pozsarzs/mm2a/pictures/mm2a-2.jpg

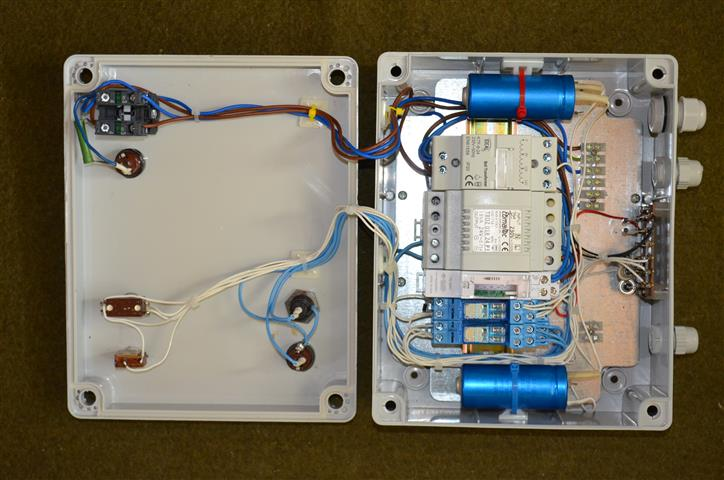
pictures/mm2a-2.jpg
