pozsarzs/mm2a/pictures/mm2a-1.jpg

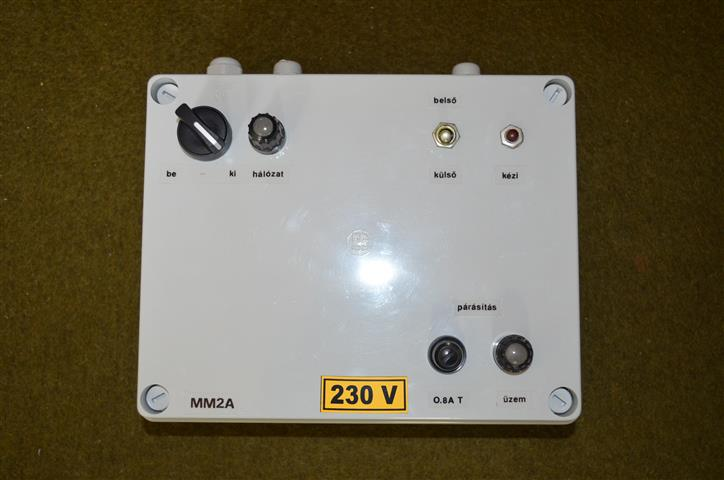
pictures/mm2a-1.jpg
