pozsarzs/mm2a/README.md

**MM2A * Analog one channel growing house controlling device**  
Copyright (C) 2017 Pozsár Zsolt <pozsarzs@gmail.com>  
Homepage: <http://www.pozsarzs.hu>  
GitHub: <https://github.com/pozsarzs/mm2a>

**Documentation**

- version:             1.1
- language:            hu
- licence:             CC-BY-NC-4.0

**Hardware**

 - version:            v170903
