pozsarzs/mm2a/documents/mm2a.pdf

## MM2A egycsatornás analóg gombatermesztő automatika

### Felhasználói leírás

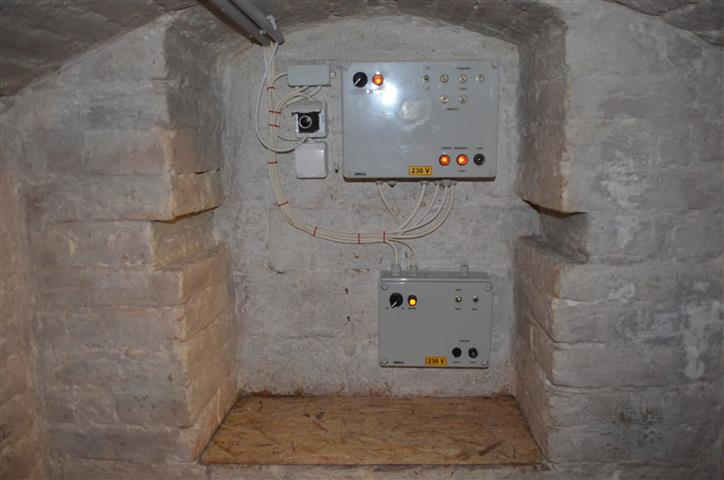
[picture p3: figure]

Hardver változat: v170903
Felhasználói leírás változat: v1.1 Kiadás dátuma: 05/09/2019

## CC-BY-NC-4.0

(59/2)

Tartalomjegyzék

Titles: | MM2A egycsatornás analóg gombatermesztő automatika Rev.: 170903 Pages: | 2/12
Felhasználói leírás
Name: Pozsár Zsolt | Date: | 2019-09-05

## I. A berendezés

Titles: | MM2A egycsatornás analóg gombatermesztő automatika Rev.: 170903 Pages: | 3/12

A készülék a szellőztető rendszertől független, 24V AC mágnesszeleppel működő párásító berendezés vezérlésére képes.

### 1. Műszaki adatok

Tápfeszültség: | 230 V AC
Teljesítményfelvétel: | max. 26 W
Szigetelési osztály: | I. osztály
Mechanikai mérete: | 240 x 190 x 90 mm
IP védettség: | IP 54
IK védettség: | IK 03
Készülékház anyaga: | termoplaszt (ABS)

### 2. Ismertetés

Üzemmódok

| Párásítás
Kézi üzem | van
Belső vezérlés | időzítő
Külső vezérlés | van
Külső vezérlő feszültség | +12 V
Külső vezérlés bemeneti áram | 40 mA
Kimeneti feszültség | 24 V AC
Kimeneti áram | 0,8 A
Kimenet védelem | olvadóbiztosíték
Kimenet visszajelzés | izzó a védelem után

A kimenet az előlapon található olvadóbiztosítékkal (Wickmann) védett. A működést a biztosíték után kapcsolt izzólámpa jelzi. (Bekapcsolt csatorna esetén a lámpa sötét állapota a biztosíték kiégésére utalhat.)

A kimenet a nyomógomb megnyomásával kézzel is aktiválható, a gomb nyomva tartásakor a kimenet kb. 10 mp után automatikusan kikapcsol.

Belső vezérlés esetén a kimenetet a beépített mechanikus időkapcsoló kapcsolja, amely 1 napos időtartamban programozható, a minimális kapcsolási idő 15 perc. A kimenet a beállított időpont elérésekor kb. 10 mp-ig marad aktív.

Külső vezérlés használatakor a bemenetre kapcsolt vezérlőfeszültség kapcsolja a kimenetet. A vonal terhelése induktív (relé), a keletkező ellenkező polaritású impulzus kioltásra kerül. A bemenet fordított

Titles: | MM2A egycsatornás analóg gombatermesztő automatika Rev.: 170903 Pages: | 4/12

polaritású feszültség ellen védett. A működési idő külső vezérlés esetén is kb. 10 mp., a bemeneti jel csak indításra szolgál.

### 3. Kapcsolási rajz

A kapcsolási rajzot az 1. számú melléklet tartalmazza. A rajz a teljes dokumentáció részeként vagy különálló PDF, SVG és KiCAD formátumban letölthető a fejlesztő/gyártó honlapjáról. (A hivatkozásokat a IV. fejezetben találja.)

### 4. Felhasználási feltételek

A hardver dokumentációja a Creativ Commons 4.0 Attribution Non-Commercial (CC-BY-NC-4.0) -„Nevezd meg!-Ne add el!” licenc alapján módosítható és/vagy terjeszthető. A licenc teljes (angol nyelvű) szövegét az interneten tudja elolvasni. (A hivatkozásokat a IV. fejezetben találja.)

### 5. Kinézet


Előlap | A készülék belseje
Titles: | MM2A egycsatornás analóg gombatermesztő automatika Rev.: 170903 Pages: | 5/12

a) Kezelőszervek és csatlakozók

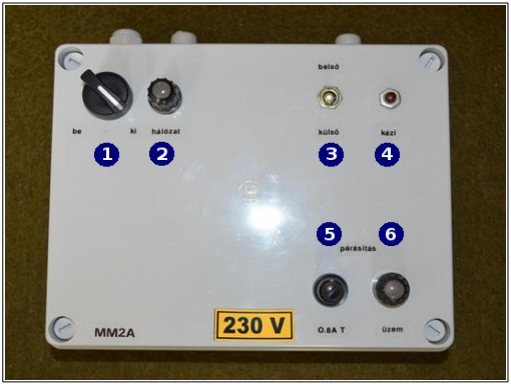
[picture p4: figure]

1: hálózati kapcsoló
2: hálózat visszajelző lámpa
3: külső/belső vezérlés kapcsoló 4: kézi párásítás
5: biztosíték
6: működést jelző lámpa

1: be- és kimeneti csatlakozó 2: külső vezérlés csatlakozó 3: időkapcsoló

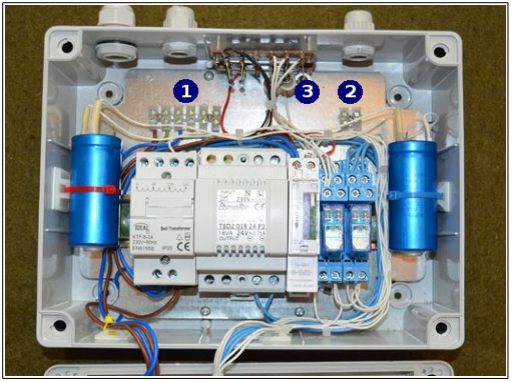
[picture p5: figure]

b) Csatlakozók lábkiosztása

Be- és kimeneti csatlakozó (1): 1: 230 V be L
2: 230 V be PE
3: 230 V be N
4: -
5: párásítás ki
6: párásítás ki

Vezérlés csatlakozó (2):
1: GND
2: párásítás külső vezérlés

(A számozás balról jobbra értendő.)

Titles: | MM2A egycsatornás analóg gombatermesztő automatika Rev.: 170903 Pages: | 6/12

### 6. Letölthető dokumentáció

A hardver teljes dokumentációja .tar.gz formátumú tömörített fájlban letölthető a gyártó honlapjáról. (A hivatkozásokat a IV. fejezetben találja.)

A letölthető csomag neve: mm2a-170903-1.1.tar.gz

A csomag tartalma:

mm2a-170903
│
├───cad_files | | | KiCAD fájlok
│ | mm2a-cache.lib | | | alkatrészkönyvtár
│ | mm2a-rescue.lib | | | alkatrészkönyvtár
│ | mm2a.pro | | | projekt fájl
│ | mm2a.sch | | | kapcsolási rajz
│
├───documents | | | dokumentáció
│ | mm2a.pdf | | | Felhasználói leírás
│ | manual-source.tar.bz2 | | | Felhasználói leírás forrás
│
├───pictures | | | képek
│ | sch_mm2a.svg | | | kapcsolási rajz
│ | mm2a-1.jpg | | | előlap
│ | mm2a-2.jpg | | | belső felépítés
│
├───LICENCE | | felhasználási feltételek
└───README | | rövid ismertető
Titles: | MM2A egycsatornás analóg gombatermesztő automatika Rev.: 170903 Pages: | 7/12

## II. Kapcsolódó hivatkozások

Titles: | MM2A egycsatornás analóg gombatermesztő automatika Rev.: 170903 Pages: | 8/12

### 1. Készülék

Teljes dokumentáció | http://www.szerafingomba.hu/equipments/mm2a/mm2a-170903-1.1.tar.gz
Felhasználói leírás | http://www.szerafingomba.hu/equipments/mm2a/user-manual-170903-1.1.pdf

Kapcsolási rajz:
PDF | http://www.szerafingomba.hu/equipments/mm2a/sch_mm2a.pdf
SVG | http://www.szerafingomba.hu/equipments/mm2a/sch_mm2a.svg
KiCAD | http://www.szerafingomba.hu/equipments/mm2a/sch_mm2a.tar.gz

### 2. Felhasználási feltételek

CC-BY-NC-4.0 (EN) | https://creativecommons.org/licenses/by-nc/4.0/legalcode
CC-BY-NC-4.0 (EN) | https://creativecommons.org/licenses/by-nc/4.0/
CC-BY-NC-4.0 (HU) | https://creativecommons.org/licenses/by-nc/4.0/deed.hu

### 3. Fejlesztő és gyártó

Honlap | https://www.szerafingomba.hu
E-mail | info@szerafingomba.hu
Titles: | MM2A egycsatornás analóg gombatermesztő automatika Rev.: 170903 Pages: | 9/12

## III. Mellékletek

Titles: | MM2A egycsatornás analóg gombatermesztő automatika Rev.: 170903 Pages: | 10/12

### 1. Kapcsolási rajzok

1. MM2A kapcsolási rajza
Titles: | MM2A egycsatornás analóg gombatermesztő automatika Rev.: 170903 Pages: | 11/12

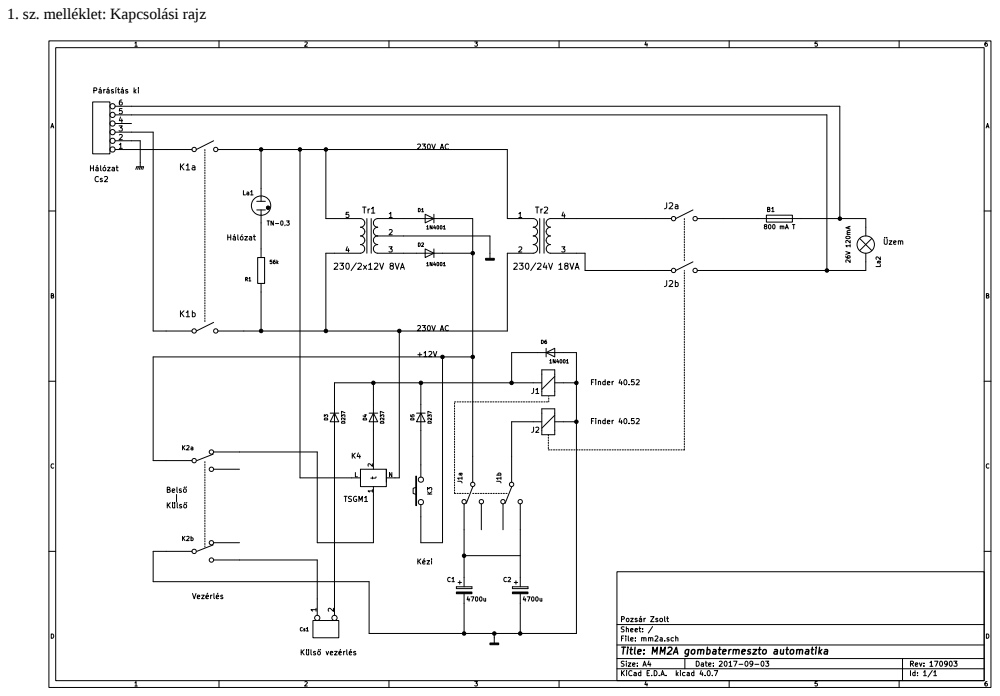
[picture p6: page 12]

1. sz. melléklet: Kapcsolási rajz
