pozsarzs/mm2a/documents/sch_mm2a.pdf

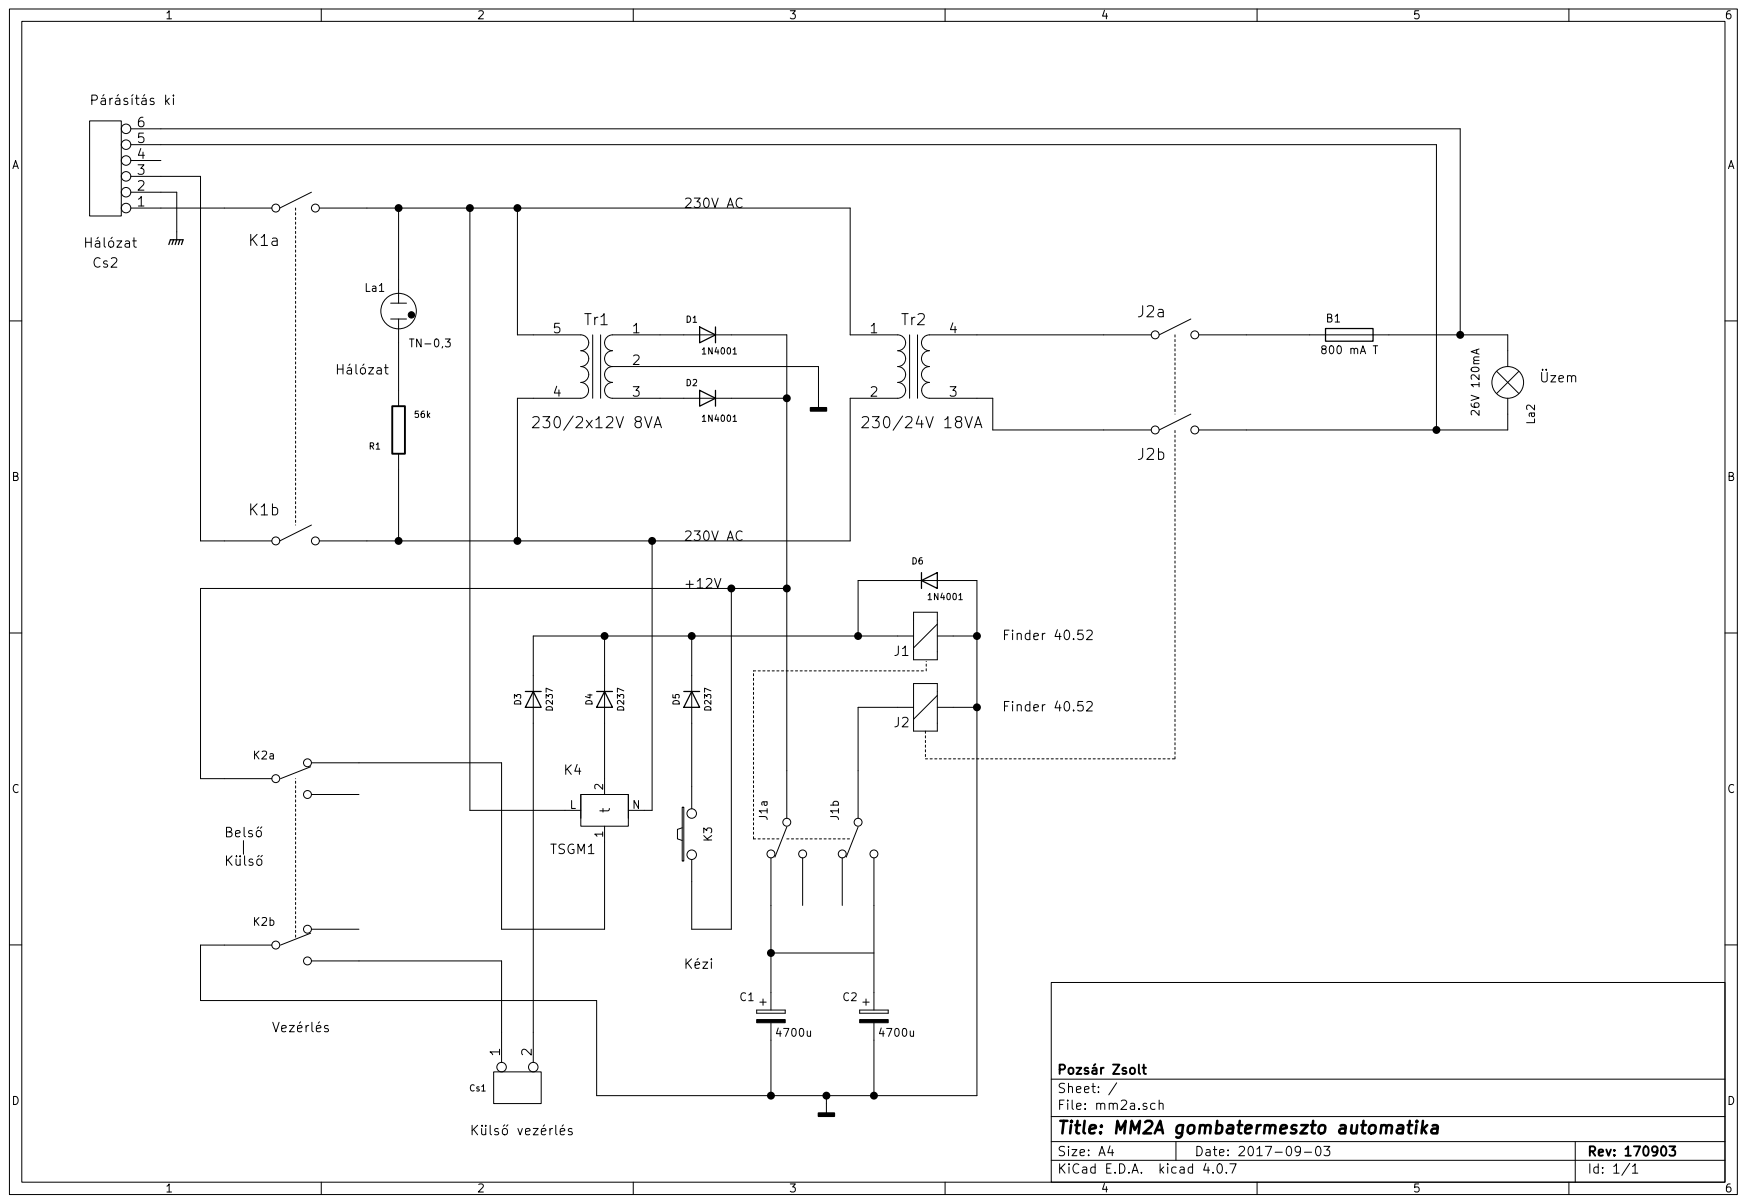
[picture p7: page 1]
