pozsarzs/mm2a/cad_files/mm2a.sch

## KiCad design cad_files/mm2a.sch (2018-12-22)

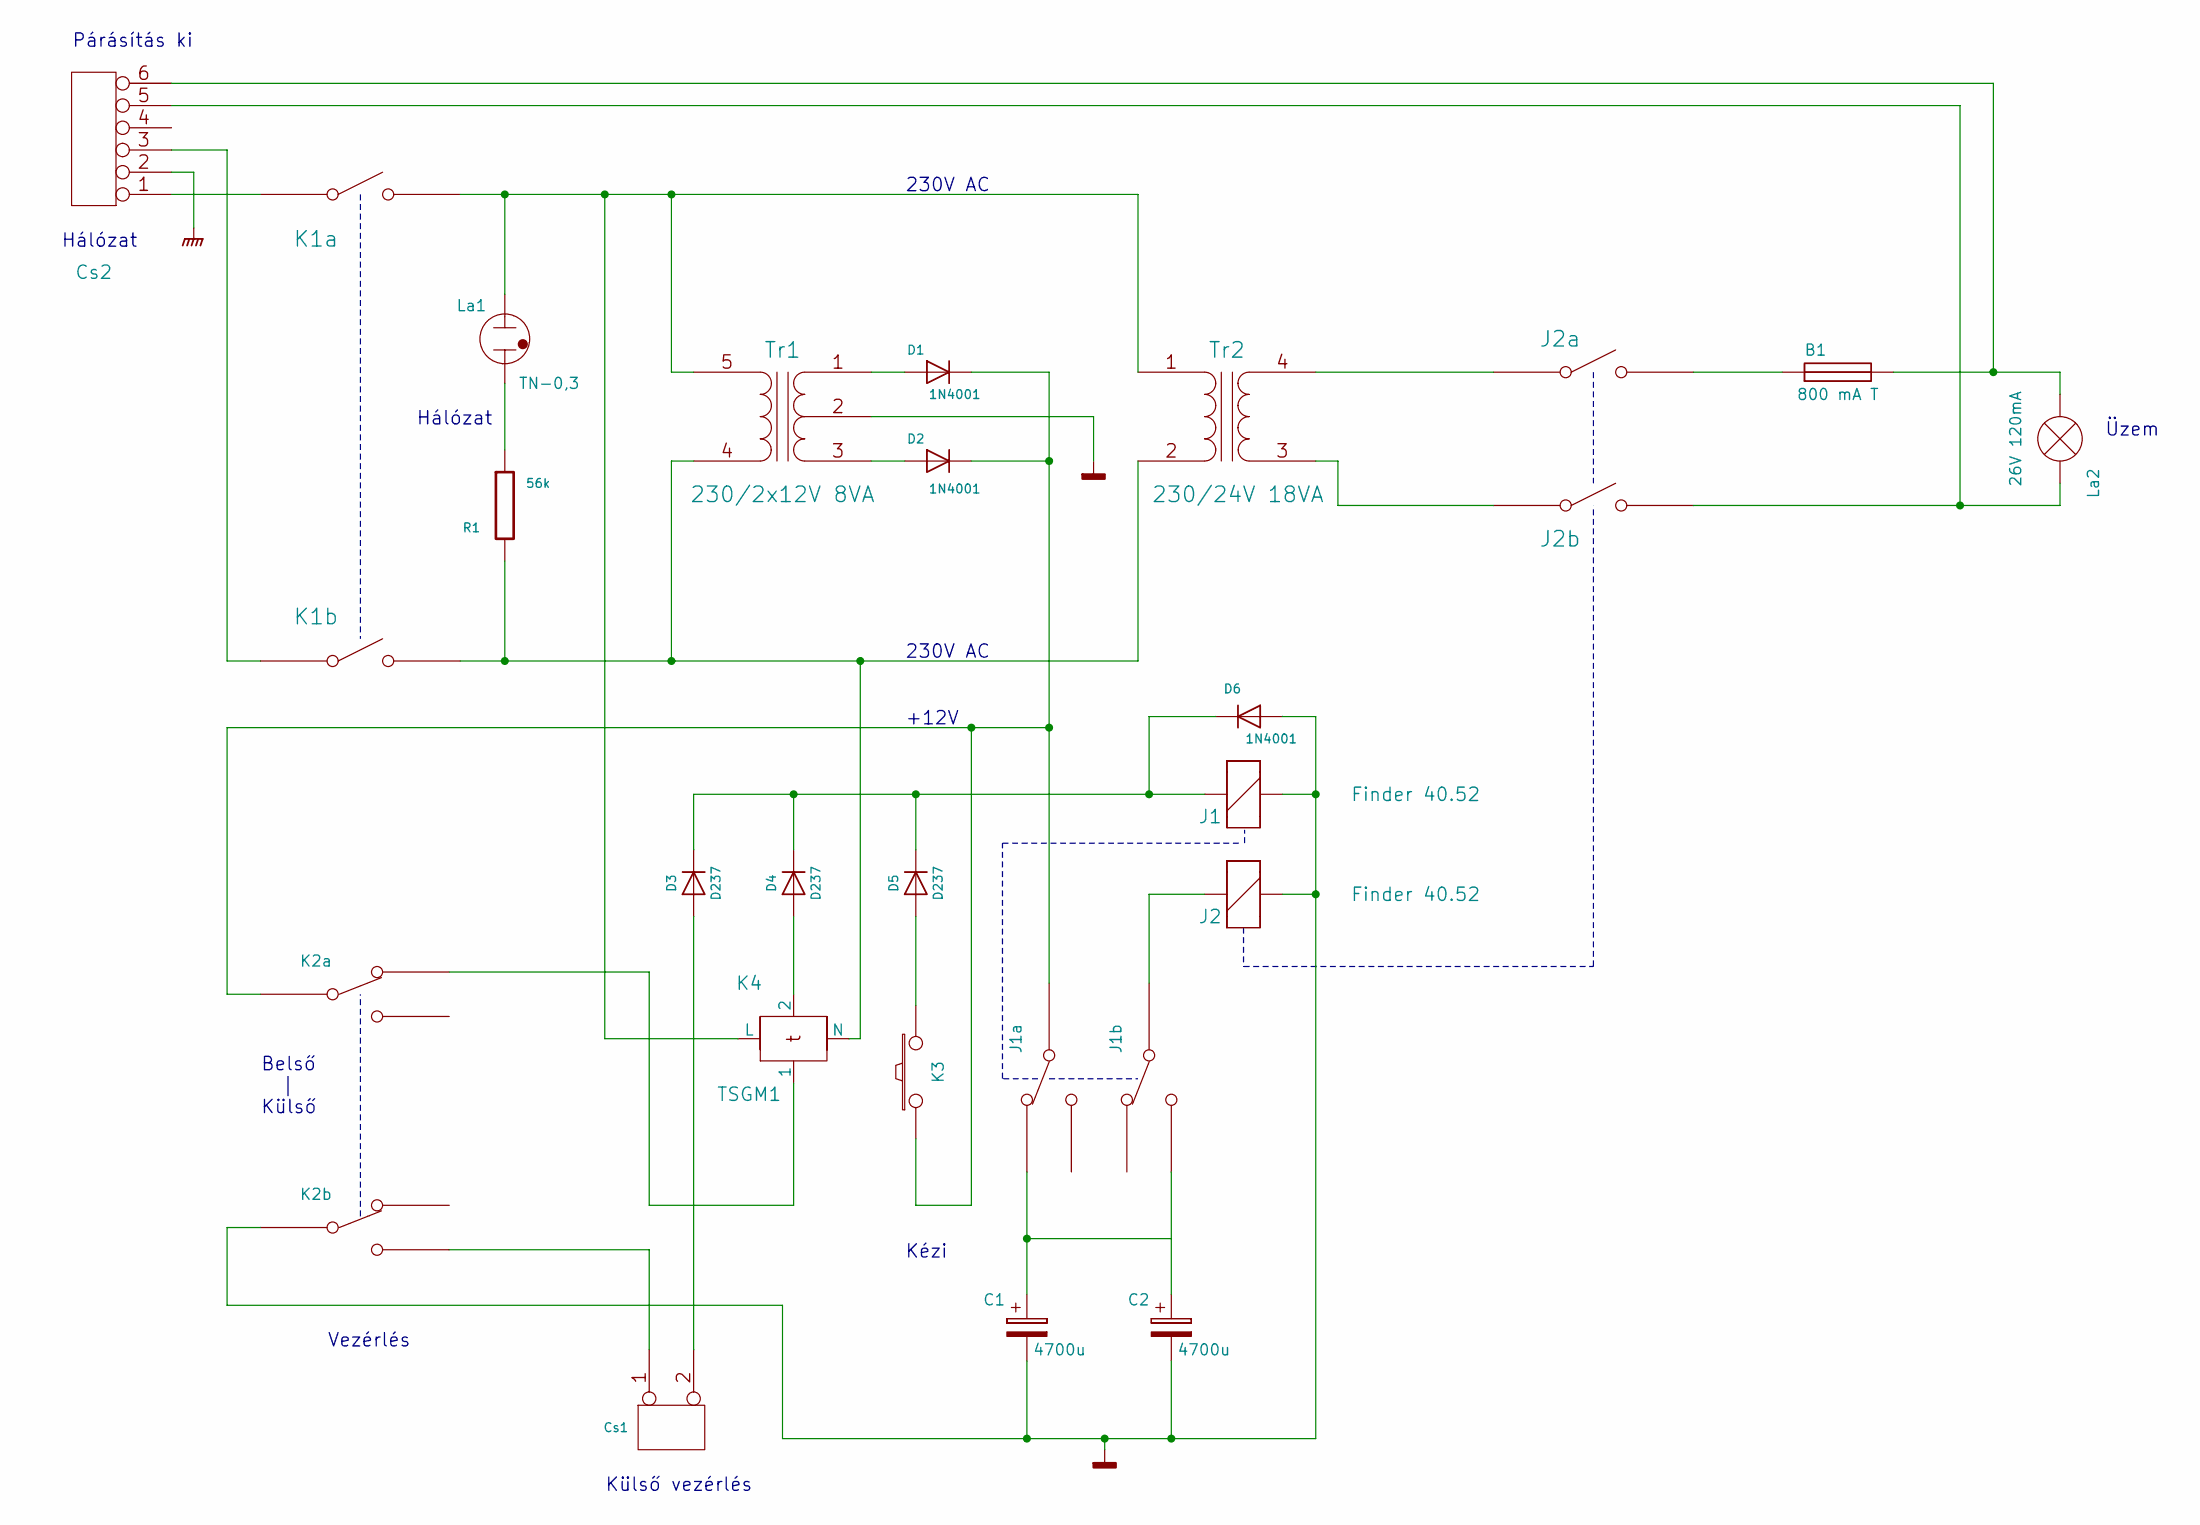
[picture p8: schematic mm2a.sch]

Parts:
B1: 800 mA T
C1, C2: 4700u
Cs1: CONN_2
Cs2: CONN_6
D1, D2, D6: 1N4001
D3, D4, D5: D237
J1, J2: Finder 40.52
J1a, J1b: SWITCH_INV
J2a, J2b: SPST
K1a, K1b: SPST
K2a, K2b: SWITCH_INV
K3: PushButton
K4: TSGM1
La1: TN-0,3; glimm
La2: 26V 120mA; lamp
R1: 56k
Tr1: 230/2x12V 8VA
Tr2: 230/24V 18VA

Connections:
GNDD: C1.2, C2.2, D6.2 (A), J1.1, J2.1, K2b.~, Tr1.2 (PM)
GNDPWR: Cs2.2
unnamed: B1.1, J2a.2
unnamed: B1.2, Cs2.6, La2.1 (-)
unnamed: C1.1, J1a.~
unnamed: C2.1, J1b.~
unnamed: Cs1.1, K2b.~
unnamed: Cs1.2 (PM), D3.2 (A)
unnamed: Cs2.1, K1a.1
unnamed: Cs2.3, K1b.1
unnamed: Cs2.5, J2b.2, La2.2 (+)
unnamed: D1.1 (K), D2.1 (K), J1a.~, K2a.~, K3.1
unnamed: D1.2 (A), Tr1.1 (PR1)
unnamed: D2.2 (A), Tr1.3 (PR2)
unnamed: D3.1 (K), D4.1 (K), D5.1 (K), D6.1 (K), J1.2
unnamed: D4.2 (A), K4.2
unnamed: D5.2 (A), K3.2
unnamed: J1b.~, J2.2
unnamed: J2a.1, Tr2.4 (SB)
unnamed: J2b.1, Tr2.3 (SA)
unnamed: K1a.2, K4.L, La1.1, Tr1.5 (S2), Tr2.1 (AA)
unnamed: K1b.2, K4.N, R1.2, Tr1.4 (S1), Tr2.2 (AB)
unnamed: K2a.~, K4.1
unnamed: La1.2, R1.1

Notes on the sheet:
Hálózat
Üzem
Külső vezérlés
Vezérlés
Kézi
Párásítás ki
230V AC
+12V
Belső | Külső
